Jake-Peyser-Git/Rocket-Accelerometer-Telemetry-Pipeline/README.md

Designed a wireless telemetry system using a Raspberry Pi Pico and WiFi-based data acquisition pipeline (Pico -> WiFi router -> PC) for 3-axis flight data with a calibration protocol for sensor bias, orientation determination, and axis scaling. This was accomplished via a combination of interconnected scripts across C++, Python, and MATLAB. The procedure was preformed as follows:

(1) Set up wireless WiFi router and PC for data collection

(2) Upload C++ accelerometer script to the pico-accelerometer unit, which instructs the pico to send accelerometer data packets to the set IP

(3) Run the python calibration script while the accelerometer is at rest in 3 distinct orientations and collect the reported instrumentation gains/biases

(4) Run the python crash test script, which prints the (desired) accelerometer data to the console and a CSV/excel file

(5) Insert the data file into the MATLAB code in conjunction with the calibration gains/biases and run the script

The output returns a plot of the raw and calibrated accelerometer data. That's it! This was an integrated sub-component of an engineering project at the Cooper Union, and so I also included the (supplementary) project report that went with it. See the appendix for the calibration algorithm documentation. 

Much thanks to Mike Giglia @ the Cooper Union for his extremely helpful software guidance. 
Another major thanks to my colleague David Brokhin for his essential hardware implementation design.

Example pre/post calibration (400g) accelerometer plots:
